Corolan/WAT_praca_magisterska/README.md

# WAT_praca_magisterska
Praca magisterska na Wojskowej Akademii Technicznej

Temat: Bezprzewodowy rozproszony system pomiaru warunków środowiskowych 

Promotor: ppłk dr inż. Tadeusz Sondej
