Corolan/WAT_praca_magisterska/pomiary/POMIARY-notatki.txt

zużycie prądu 

63.7 mA-80.9mA

początek pomiarów 12:07 01.05.2021
koniec 23:10
